edmilsons2025/klipper-chamber-dht22/(commit log)

2026-10-03 Sensor DHT22 da câmara no Orange Pi, módulo do Klipper e painel Chamber no Mainsail
    [camara_pi.cfg]
2026-10-03 Licença MIT e README sem a seção de problemas
2026-10-03 Firmware alternativo para ESP8266 (NodeMCU) e ESP32
    Serve o mesmo GET /camara do Orange Pi, então o módulo do Klipper e o
    painel Chamber funcionam sem mudanças. Compilado para nodemcuv2 e
    ESP32 Dev Module; ainda não testado em hardware.
2026-10-07 Instalador automático (install.sh) para Pi, Klipper e Mainsail
    Claude-Session: https://claude.ai/code/session_01WNaQk84GDnhHbWRj4SZbDs
2026-10-07 Contrato HTTP explícito: módulo aceita qualquer campo, fonte de exemplo e --url no instalador
    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
    [camara_pi.cfg]
